UTZbox/midiGPIO/pictures/midiGPIO_outside.jpeg

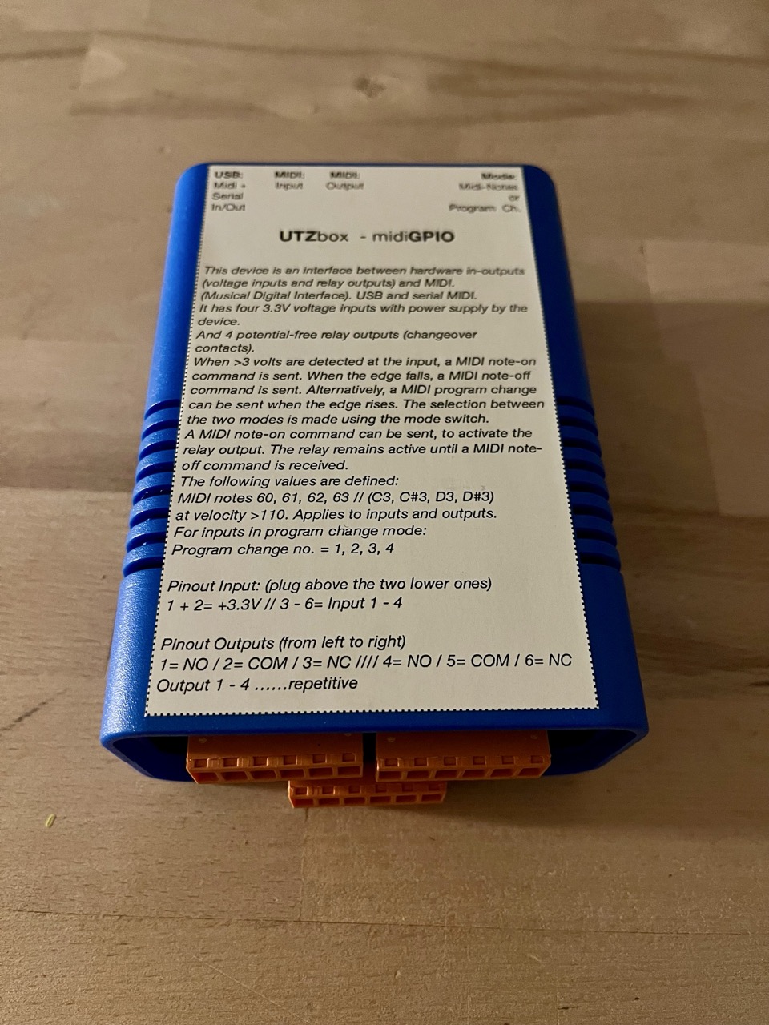
pictures/midiGPIO_outside.jpeg
