UTZbox/midiGPIO/pictures/midiGPIO_inside.jpeg

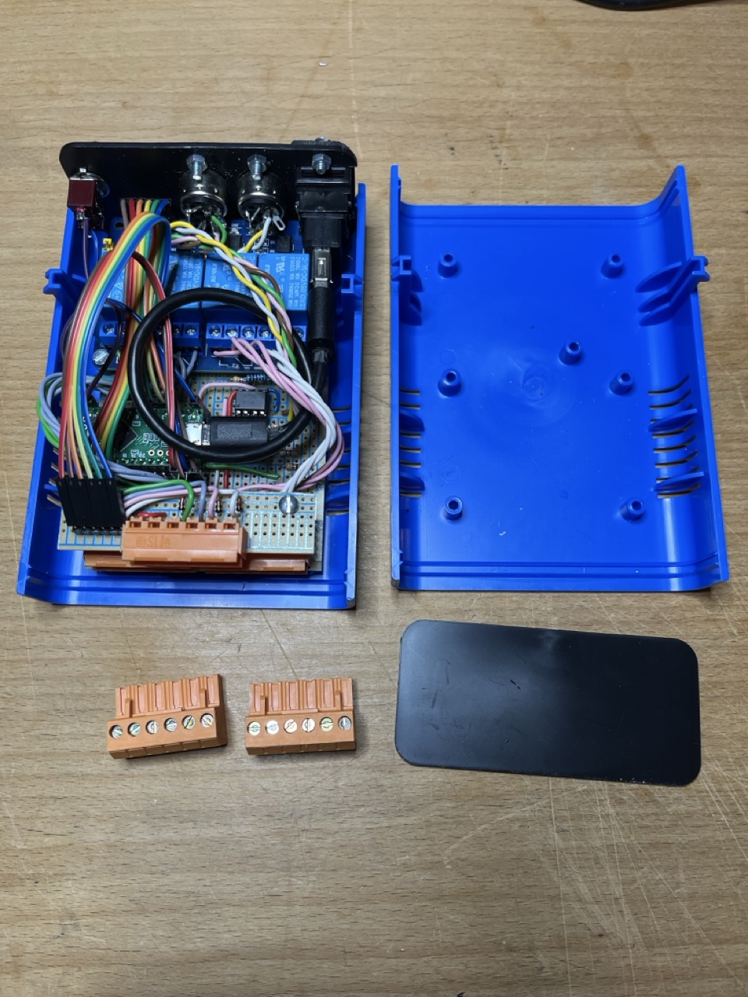
pictures/midiGPIO_inside.jpeg
