UTZbox/midiGPIO/schematics/UTZbox_midiGPIO_schematics.pdf

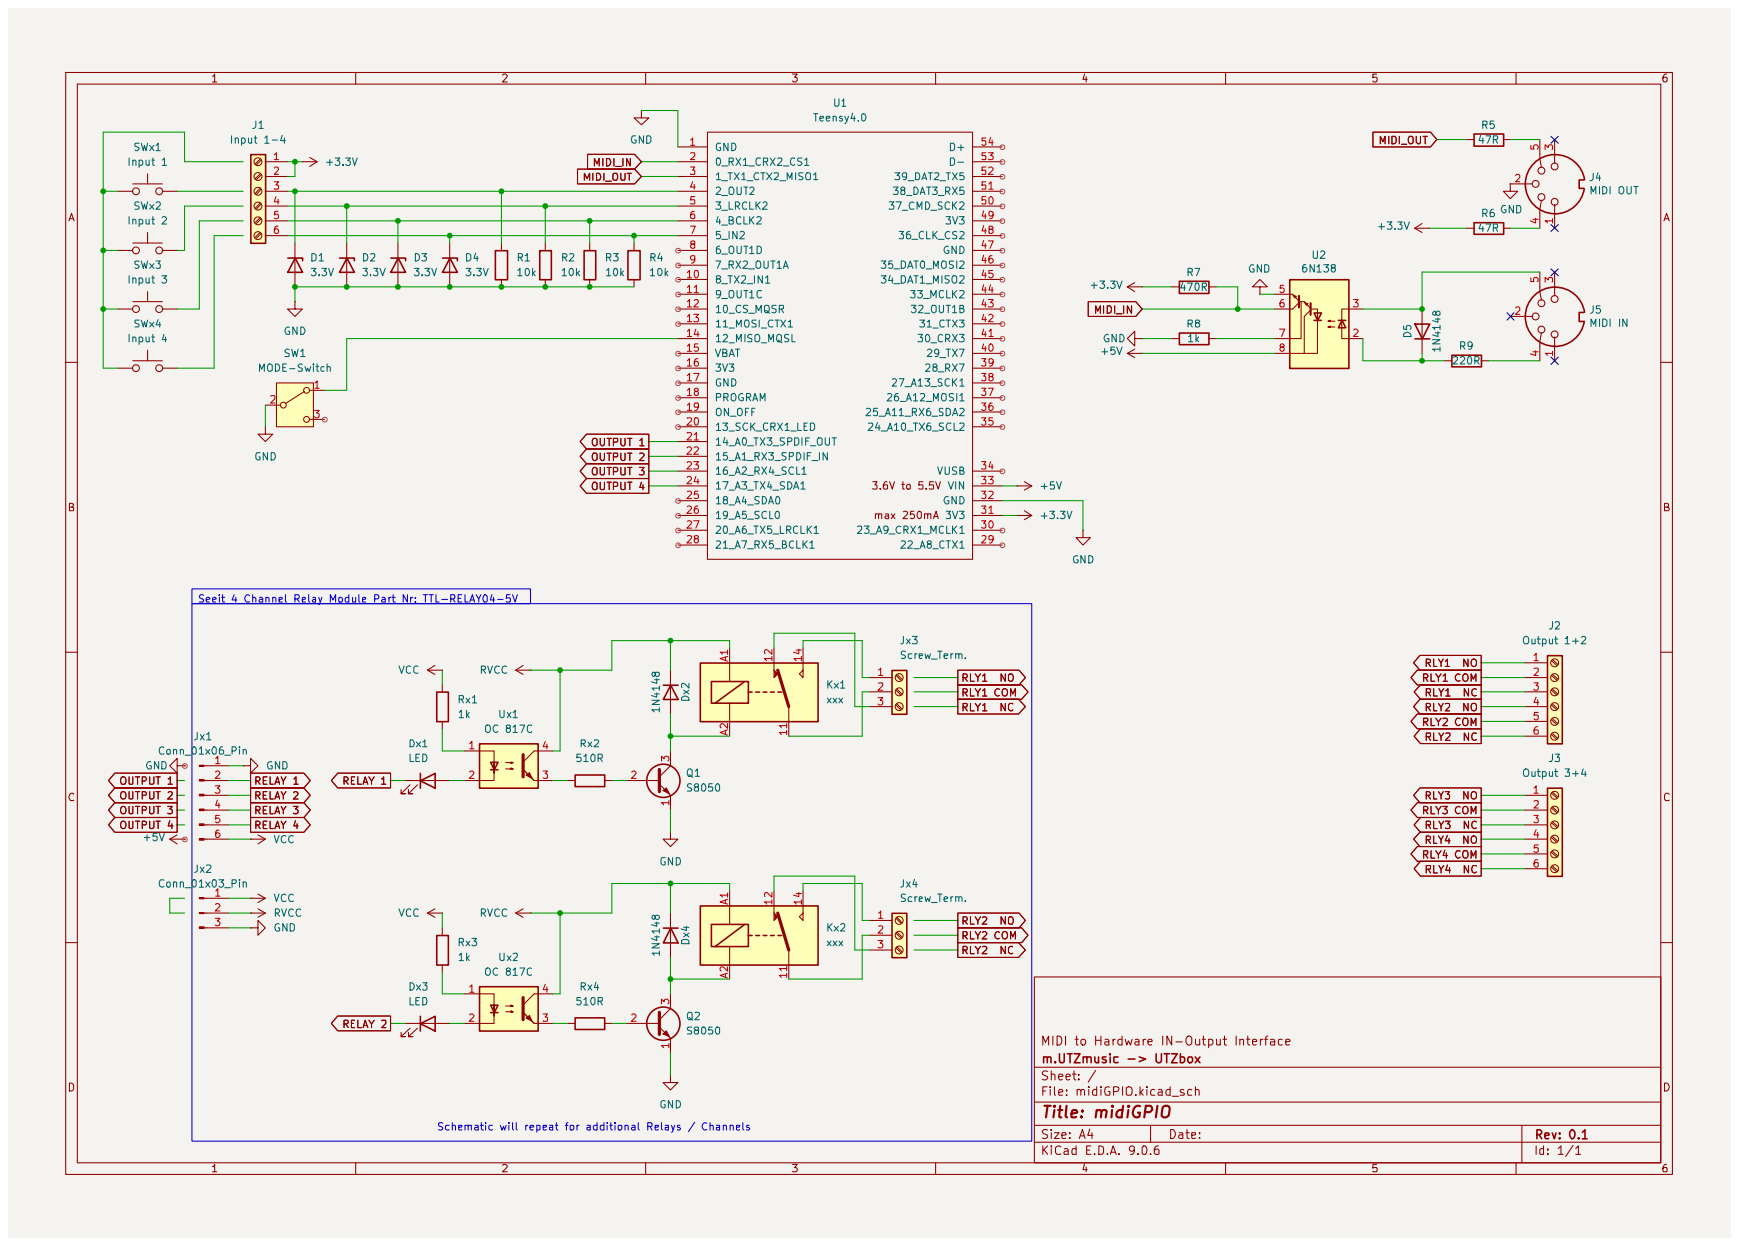
[picture p3: page 1]
