UTZbox/midiGPIO/sourceCode/midiGPIO_v0.2.2/name.c

// To give your project a unique name, this code must be
// placed into a .c file (its own tab).  It can not be in
// a .cpp file or your main sketch (the .ino file).

#include "usb_names.h"

// Edit these lines to create your own name.  The length must
// match the number of characters in your custom name.

#define MANUFACTURER_NAME  {'U','T','Z','B','o','x'}
#define MANUFACTURER_NAME_LEN 6

#define PRODUCT_NAME    {'M','i','d','i','G','P','I','O'}
#define PRODUCT_NAME_LEN  8

// Do not change this part.  This exact format is required by USB.

struct usb_string_descriptor_struct usb_string_manufacturer_name = {
  2 + PRODUCT_NAME_LEN * 2,
  3,
  MANUFACTURER_NAME
};

struct usb_string_descriptor_struct usb_string_product_name = {
  2 + PRODUCT_NAME_LEN * 2,
  3,
  PRODUCT_NAME
};
