UTZbox/midiGPIO/(commit log)

2026-01-05 Add comments for schematics build instructions
2026-01-05 Add comments about Teensy source code
2026-01-05 Add comments for source code
    Add comments for Teensy/Arduino source code location
2026-01-05 Update section header for board connections
